Zokhoi/ArcBtnBox/README.md

# Zok's ArcBtnBox
This is a handwired 5 button arcade button controller that I made out of a random plastic box.

The internal dimensions of the box are about 110mm W x 80mm D x 33mm H.

An Arduino Pro Micro type C variant was used with direct pin connection and internal pull-up resistors.

## Bill of Materials
| Part | Details | Quantity | Notes |
|---|---|---|---|
| Sanwa arcade buttons | 24mm | 5 | Commonly available variant has [SW-68 switches](https://github.com/Zokhoi/Arcade-Switches/blob/master/doc/Switches.md#sanwa-sw-68),<br /> which uses 2.8mm lug connectors (#110タブ) |
| Arduino Pro Micro | Type C variant | 1 | I hate micro B connector with a passion |
| Arduino Pro Micro headers | 12-pin header  | 1 | Only one side of the microcontroller needs to be soldered with header |
| DuPont wires | Male-female | Number of arcade buttons plus  1 | For connecting pins of microcontroller to buttons |
| DuPont wires / Jumpers | Male-male | Number of arcade buttons minus 1 | For connecting one leg each of all buttons together |
| M2 screws |  4mm length | 9 | |
| M2 washer | | 9 | |
| M2 standoffs |  ↓ | ↓ | All standoffs with male side have 4mm head length |
| M2 standoffs - Female-female |  3mm length | 4 | For securing microcontroller |
| M2 standoffs - Male-female |  3mm length | 5 | For assembling 33mm support pillars |
| M2 standoffs - Male-female | 10mm length | 10 | For assembling 33mm support pillars |
| M2 standoffs - Female-female | 10mm length | 5 | For assembling 33mm support pillars |
| Rubber feet | | 4 | Make sure that the feet is higher than screw head + washer |

For 33mm support pillars with female-female ends, this is how I assemble them: <br />
|========|----  |========|  ----|========|  ----|=| <br />
10mm F-M,  10mm F-F,  10mm M-F,  3mm M-F <br />
Five support pillars are used in my design to offset the force hitting on the arcade buttons.

## Assembly

Some tips:
* 33mm is just barely deeper than commonly available Sanwa 24mm arcade buttons using SW-68 switches, which is about 29mm deep when mounted on the plastic box lid, minus the plate thickness of ~1mm.
  * A box like [this](https://item.taobao.com/item.htm?id=9425109598&ns=1&skuId=3605234230708) or [this](https://item.taobao.com/item.htm?id=644880553856&skuId=4815185538373) should be good <br />
    plastic box dimensions
* The top plastic cover of the box measures about 1mm thick, which is usable for the arcade buttons requiring 1.2mm thick mounting plate.
* Be careful drilling holes on plastic box as it might crack. Safer to use soldering iron to melt holes and then clean up the melted plastic using a utility knife with a long blade.
* For all the screw holes, use screws with washers or a large flat head to distribute the pressure around the plastic plate.
* Choose a suitable length of DuPont wires with enough slack to route the wires, but not too much that it becomes hard to contain all the wires in the box. I used 20cm wires but 10cm might have worked better.
* If you got soldering flux into the switches body and the buttons feel sticky, don't worry, you can open the arcade button and even the switches themselves to clean them. Alcohol works best to dissolve the flux.

Top design: <br />
Top

For the top, basically you need to make holes for the arcade buttons of about 25mm diameter, as an exact 24mm would be too tight of a fit.

Then at the corner between each button, make a hole for screws to secure the support pillar.

Top

For the bottom, choose one side that you can place the microcontroller without it touching anything (generally bottom left or right).

On the wall of the side you have chosen, make a hole for the microcontroller USB port to fit into.

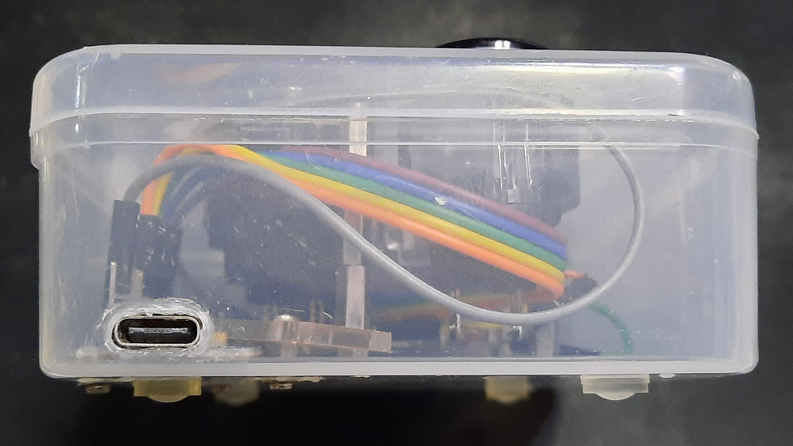
[picture p1: img/side.png]
Side


Then make four holes for securing extra standoffs that would keep the microcontroller in place. I also added a random piece of acrylic with a M2.5 hole to secure the microcontroller, using an extra M2 screw and washer.

If you would like the box to be extra secure, you can make 5 more holes and screw in the support pillars on the underside. You would need 5 more M2 screws and washers each.

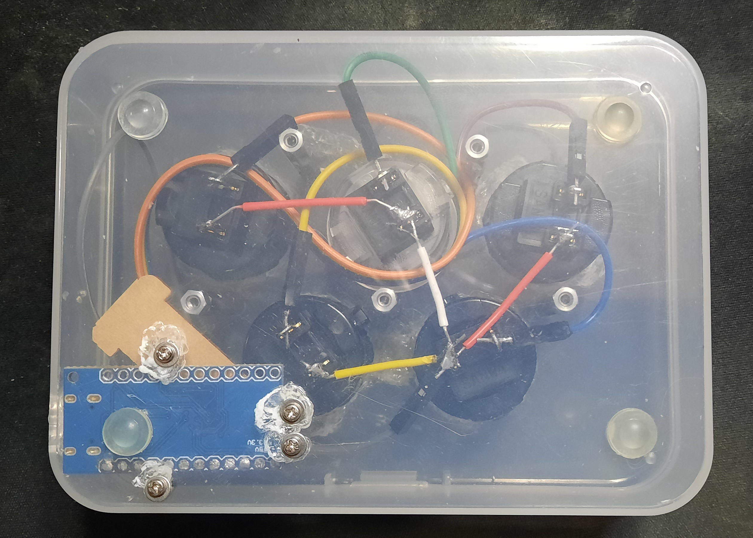
[picture p2: img/bottom.png]
Bottom


For connecting the microcontroller, you should only solder one side of the microcontroller with header. The header retainer thing can be pushed down to make the header sit flush with the microcontoller's back side, so the microcontroller can sit flat in the box.

Then, connect one leg each of all the arcade buttons together by soldering the male-male DuPont wires or jumpers, and solder the male side of one male-female DuPont wire to the connected legs. The female connector then go on the controller's ground pin.

After that, solder the remaining male-female DuPont wires with male side to each of the remaining legs on the arcade buttons. The female side go on the data pins on the microcontroller.

For my configuration, the five buttons labelled 1 to 5 uses the leftmost 5 data pins on the header, which are pins 10, 16, 14, 15 and A0 respectively.
