Zokhoi/ArcBtnBox/img/bottom_3btn.png

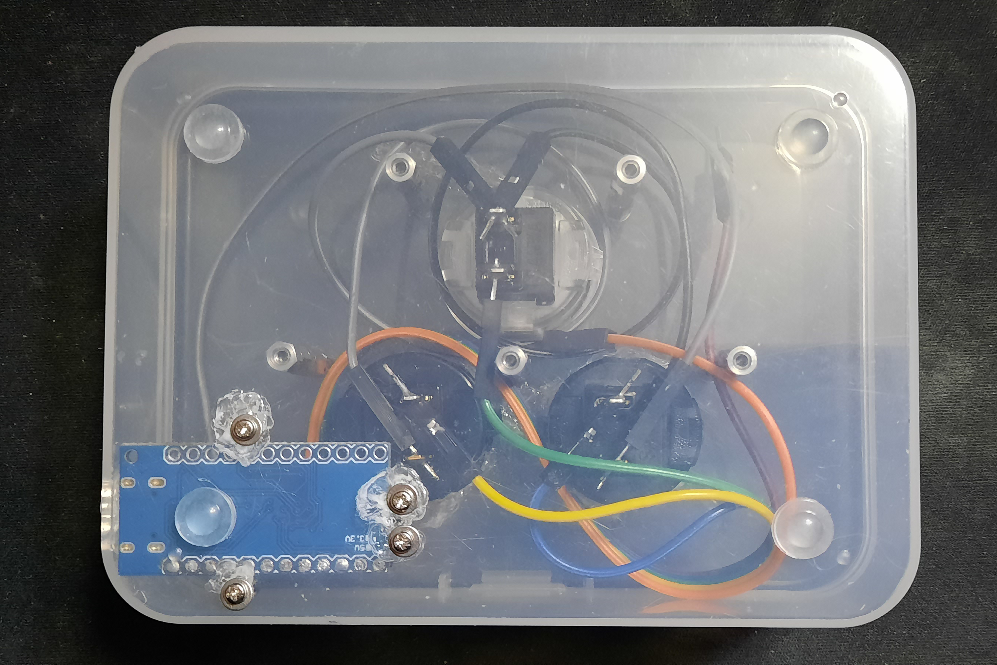
img/bottom_3btn.png
