Zokhoi/ArcBtnBox/img/side_3btn.png

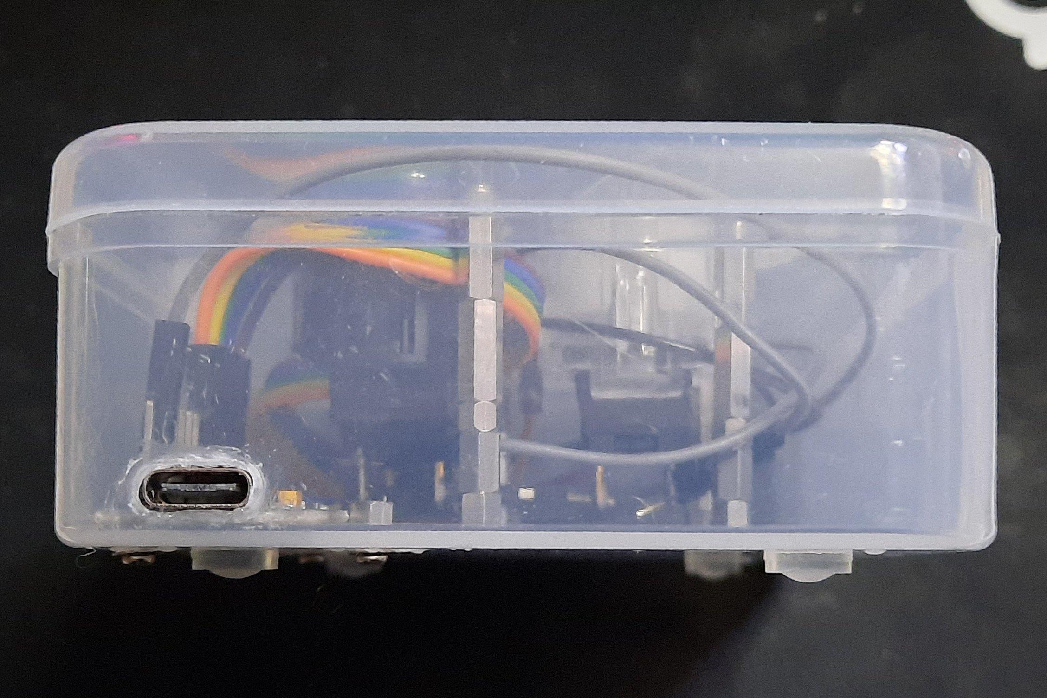
img/side_3btn.png
