Zokhoi/ArcBtnBox/arduino/keys.h

#define KEY_NONE 0x00
#define KEY_A 0x61
#define KEY_B 0x62
#define KEY_C 0x63
#define KEY_D 0x64
#define KEY_E 0x65
#define KEY_F 0x66
#define KEY_G 0x67
#define KEY_H 0x68
#define KEY_I 0x69
#define KEY_J 0x6A
#define KEY_K 0x6B
#define KEY_L 0x6C
#define KEY_M 0x6D
#define KEY_N 0x6E
#define KEY_O 0x6F
#define KEY_P 0x70
#define KEY_Q 0x71
#define KEY_R 0x72
#define KEY_S 0x73
#define KEY_T 0x74
#define KEY_U 0x75
#define KEY_V 0x76
#define KEY_W 0x77
#define KEY_X 0x78
#define KEY_Y 0x79
#define KEY_Z 0x7A
#define KEY_LEFT_CTRL 0x80
#define KEY_LEFT_SHFT 0x81
#define KEY_LEFT_ALT 0x82
#define KEY_LEFT_GUI 0x83
#define KEY_RIGHT_CTRL 0x84
#define KEY_RIGHT_SHFT 0x85
#define KEY_RIGHT_ALT 0x86
#define KEY_RIGHT_GUI 0x87
#define KEY_ENTR 0xB0
#define KEY_ESC 0xB1
#define KEY_BACKSPACE 0xB2
#define KEY_TAB 0xB3
#define KEY_CAPS_LOCK 0xC1
#define KEY_F1 0xC2
#define KEY_F2 0xC3
#define KEY_F3 0xC4
#define KEY_F4 0xC5
#define KEY_F5 0xC6
#define KEY_F6 0xC7
#define KEY_F7 0xC8
#define KEY_F8 0xC9
#define KEY_F9 0xCA
#define KEY_F10 0xCB
#define KEY_F11 0xCC
#define KEY_F12 0xCD
#define KEY_PRNT_SCR 0xCE
#define KEY_SCRL_LOCK 0xCF
#define KEY_PAUSE 0xD0
#define KEY_F13 0xF0
#define KEY_F14 0xF1
#define KEY_F15 0xF2
#define KEY_F16 0xF3
#define KEY_F17 0xF4
#define KEY_F18 0xF5
#define KEY_F19 0xF6
#define KEY_F20 0xF7
#define KEY_F21 0xF8
#define KEY_F22 0xF9
#define KEY_F23 0xFA
#define KEY_F24 0xFB
#define KEY_INSERT 0xD1
#define KEY_HOME 0xD2
#define KEY_PG_UP 0xD3
#define KEY_DELETE 0xD4
#define KEY_END 0xD5
#define KEY_PG_DOWN 0xD6
#define KEY_RIGHT_ARROW 0xD7
#define KEY_LEFT_ARROW 0xD8
#define KEY_DOWN_ARROW 0xD9
#define KEY_UP_ARROW 0xDA
#define KEY_NUM_LOCK 0xDB
#define KEY_KP_SLASH 0xDC
#define KEY_KP_ASTERISK 0xDD
#define KEY_KP_MINUS 0xDE
#define KEY_KP_PLUS 0xDF
#define KEY_KP_ENTR 0xE0
#define KEY_KP_1 0xE1
#define KEY_KP_2 0xE2
#define KEY_KP_3 0xE3
#define KEY_KP_4 0xE4
#define KEY_KP_5 0xE5
#define KEY_KP_6 0xE6
#define KEY_KP_7 0xE7
#define KEY_KP_8 0xE8
#define KEY_KP_9 0xE9
#define KEY_KP_0 0xEA
#define KEY_KP_DOT 0xEB
#define KEY_MENU 0xED
